DanielYWoo/voc-monitor/(commit log)

2026-05-03 remove long press code, use a flag for MG135 calibration
2026-05-04 button and display ok
2026-05-06 add case
    [case.scad]
2026-05-06 fix web server, add boot screen for wifi
    [case.scad]
2026-05-08 optimization of the alarm display
    [case.scad]
2026-05-10 fix button
